botanicfields/PCB-MBUS-Module-RTC/PCBV01L01/image/back.jpg

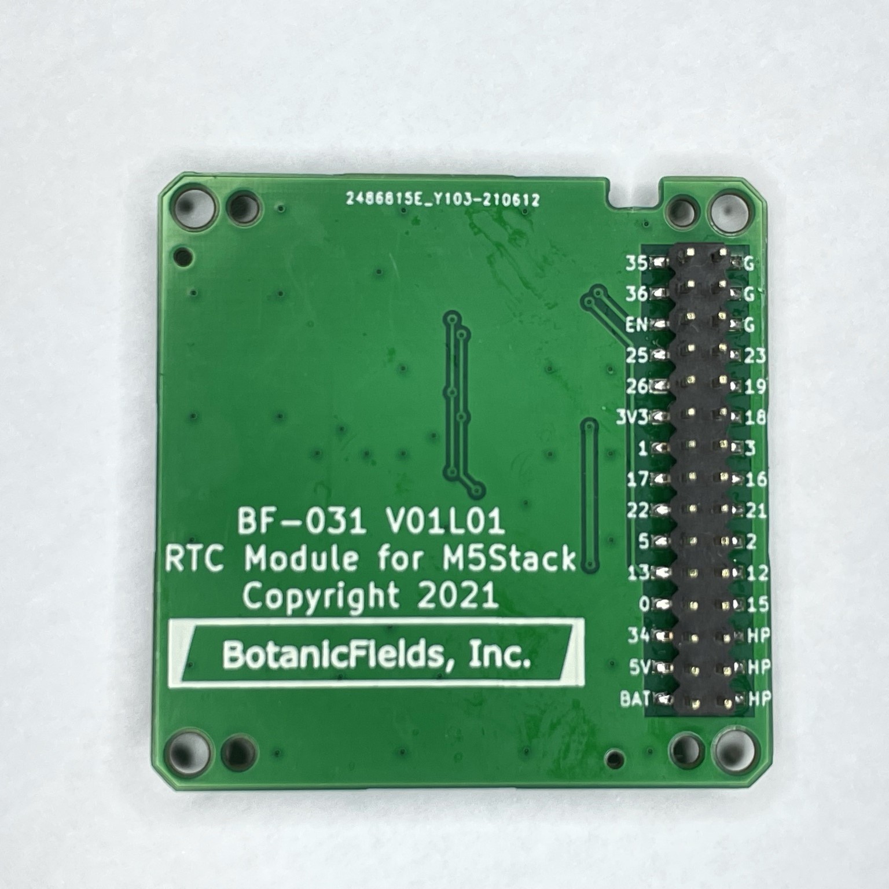
PCBV01L01/image/back.jpg
