botanicfields/PCB-MBUS-Module-RTC/PCBV01L01/image/module1.JPEG

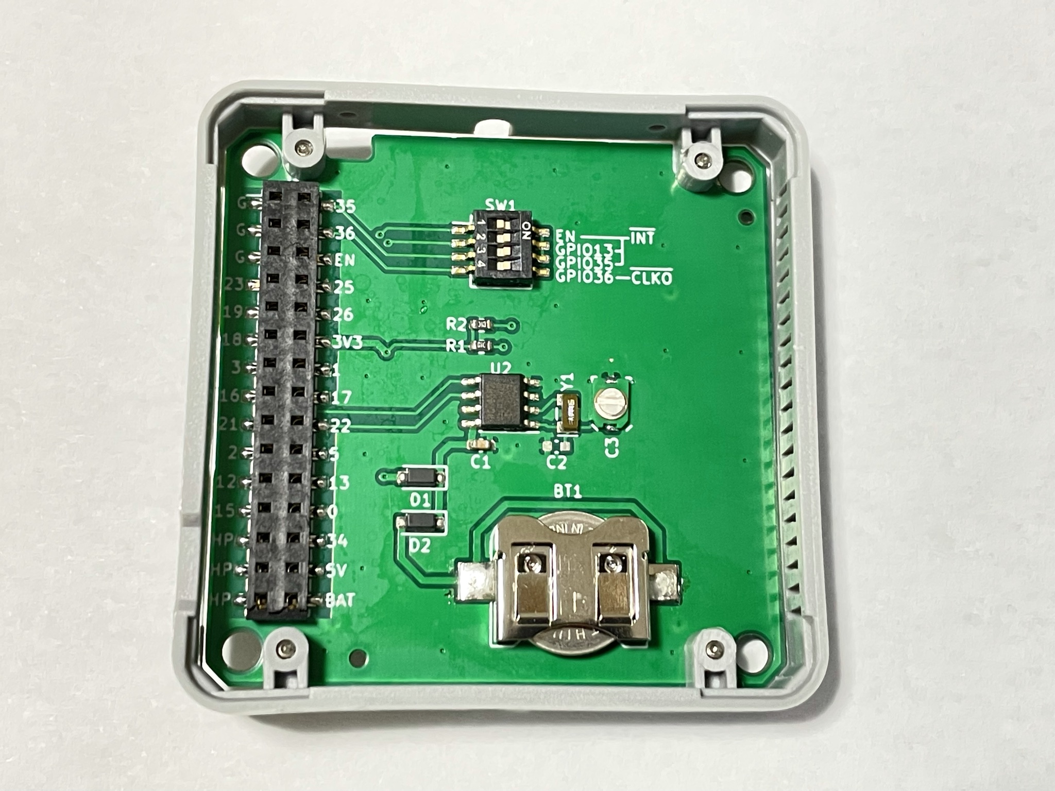
PCBV01L01/image/module1.JPEG
