botanicfields/PCB-MBUS-Module-RTC/PCBV01L01/image/module2.JPEG

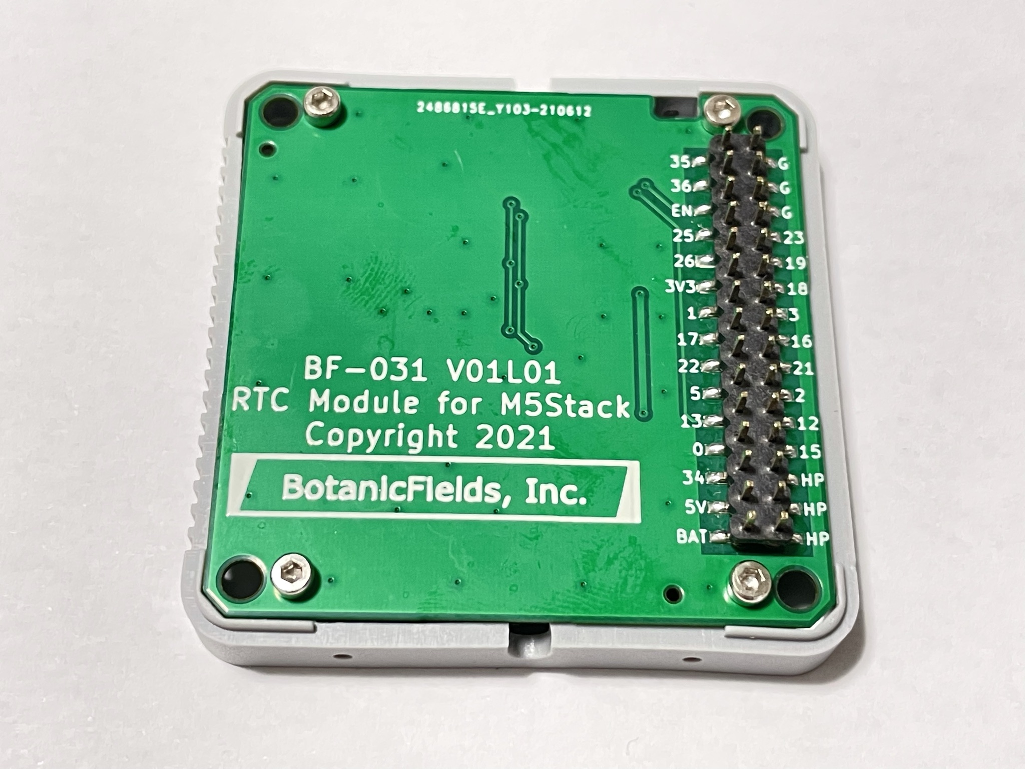
PCBV01L01/image/module2.JPEG
