botanicfields/PCB-MBUS-Module-RTC/bf-031_scm.pdf

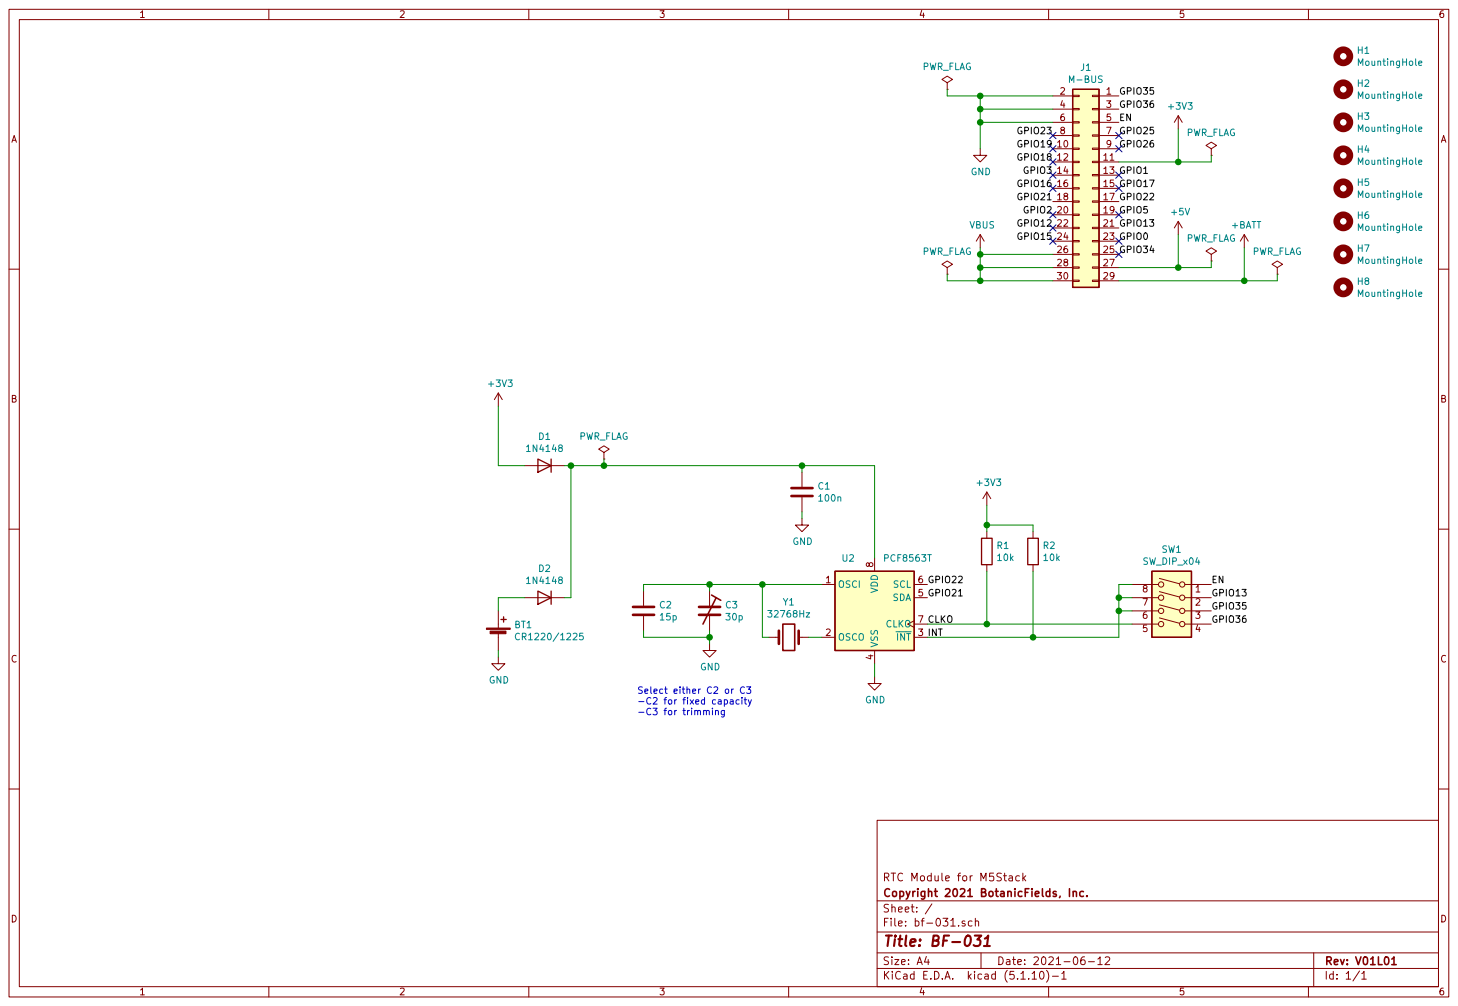
[picture p19: page 1]

File: bf-031.sch Sheet: / Copyright 2021 BotanicFields, Inc. RTC Module for M5Stack D2

4 SDA 5 SCL 6 CLKO 7 VDD
