botanicfields/PCB-MBUS-Module-RTC/PCBV01L02/KiCad/bf-031.kicad_pcb

## KiCad design PCBV01L02/KiCad/bf-031.kicad_pcb (2021-07-25)

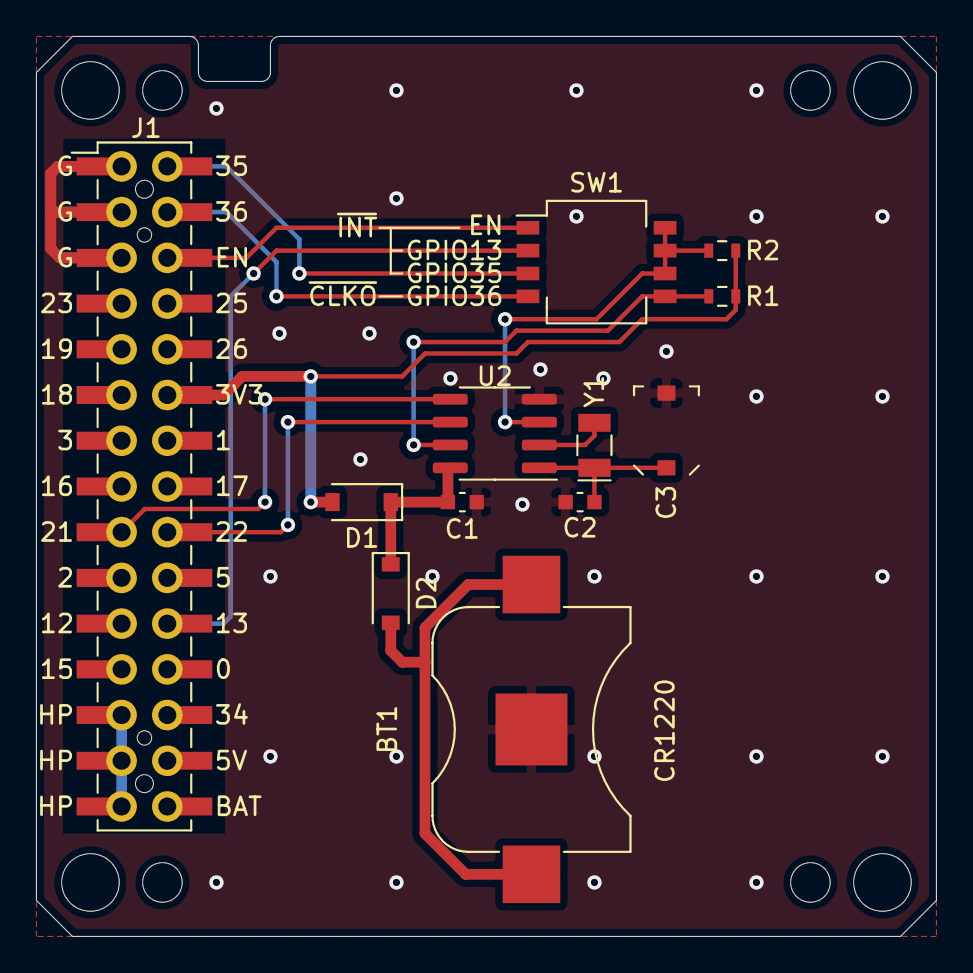
[picture p20: board bf-031.kicad_pcb from above]

Board: 2 copper layers, 50.0 x 50.0 mm, 20 parts (0 on the bottom side), 15 nets.

Parts:
BT1: CR1220/1225; BF@BatteryHolder_Takachi_SMTM1225
C1: 100n; BF@C_0603_1608Metric
C2: 15p; BF@C_0603_1608Metric
C3: 30p; C_Trimmer_Murata_TZC3
D1, D2: 1N4148; BF@D_SOD-123
H1, H2, H3, H4: MountingHole; BF@MountingHole_3.2mm_M3
H5, H6, H7, H8: MountingHole; BF@MountingHole_2.2mm_M2
J1: M-BUS; BF@M5Stack_MBUS
R1, R2: 10k; BF@R_0603_1608Metric
SW1: SW_DIP_x04; BF@SW_DIP_SPSTx04_Slide_XKB_DSHP04TS-S_W7.62mm_P1.27mm
U2: PCF8563T; SOIC-8_3.9x4.9mm_P1.27mm
Y1: 32768Hz; Crystal_SMD_MicroCrystal_CC7V-T1A-2Pin_3.2x1.5mm

Connections:
+3V3: D1.2, J1.11, R1.1, R2.1
/CLKO: R1.2, SW1.5, U2.7
/EN: J1.5, SW1.1
/GPIO13: J1.21, SW1.2
/GPIO21: J1.18, U2.5
/GPIO22: J1.17, U2.6
/GPIO35: J1.1, SW1.3
/GPIO36: J1.3, SW1.4
/INT: R2.2, SW1.6, SW1.7, SW1.8, U2.3
GND: BT1.2, C1.2, C2.2, C3.2, J1.2, J1.4, J1.6, U2.4
unnamed: BT1.1, D2.2
unnamed: C1.1, D1.1, D2.1, U2.8
unnamed: C2.1, C3.1, U2.1, Y1.1
unnamed: U2.2, Y1.2
VBUS: J1.26, J1.28, J1.30
