botanicfields/PCB-MBUS-Module-RTC/(commit log)

2021-06-25 the first upload
    the first upload
    [bf-031.kicad_pcb, bf-031.sch, bf-031_bom.csv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]
2021-06-26 README.md
    add calibration process
2021-09-19 Arduino-ESP32 2.0.0
    <time.h>
    panic of WifiManager
2021-10-07 Update BF_Pcf8563.cpp
    fix bug of tm_mon in ReadTime
    [BF_Pcf8563.cpp]
2021-11-07 Refine Demonstrations
    On/Off CLKO and INT by Buttons
2021-11-13 M5 Board Manager 2.0.0
    I2C process to update RTCx by SNTP callback, etc.
2021-12-18 exmaples
    add unsigned related to millis()
2022-01-08 Update BF-031.ino
    name of variable timer_interval
2022-11-01 Update README.md
    frame of proto module
2023-04-22 Update bf-031_doc.pdf
    add proto-module frames
